mehnajjimy/ColdPlateTwin/docs/figures/coldplate_closeup.png

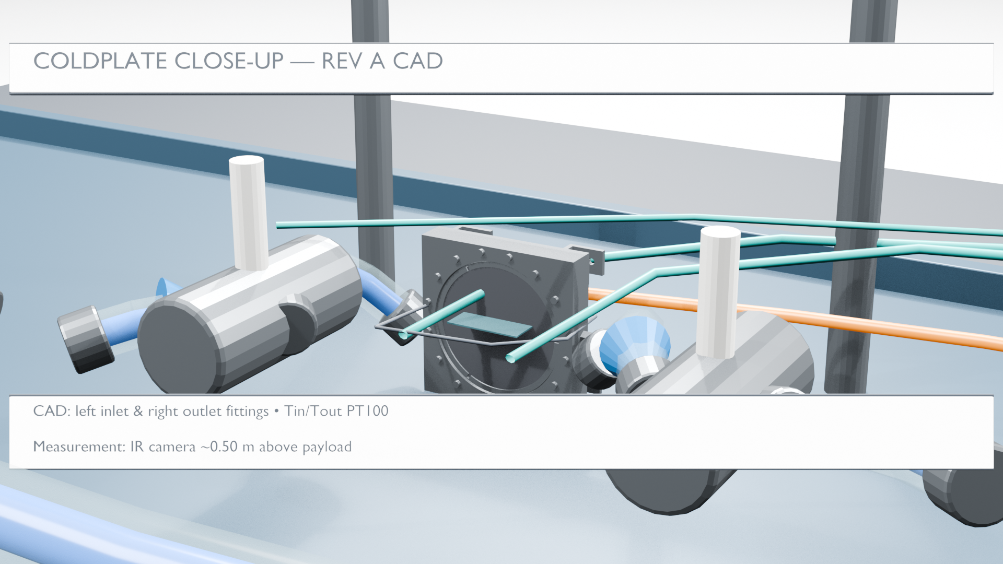
docs/figures/coldplate_closeup.png
