mehnajjimy/ColdPlateTwin/exports/step/FI-200_fluid_domain.step

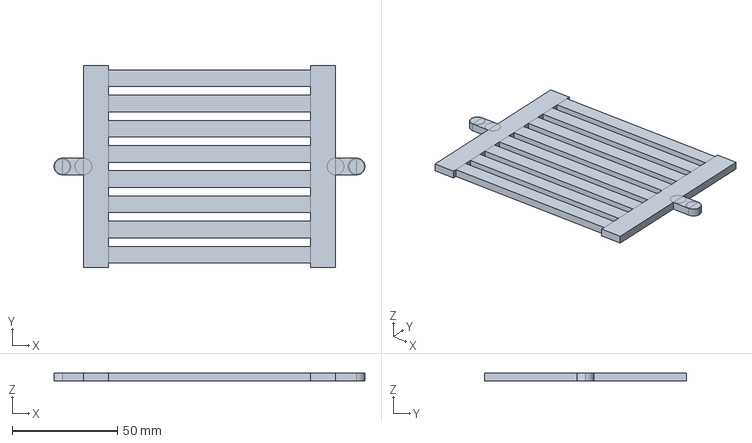
[picture p5: CAD file, 2026-09-17]
exports/step/FI-200_fluid_domain.step
148.0 x 96.0 x 4.00 mm
