mehnajjimy/ColdPlateTwin/visualization/blender_mesh/coldplate_assembly_meters.obj

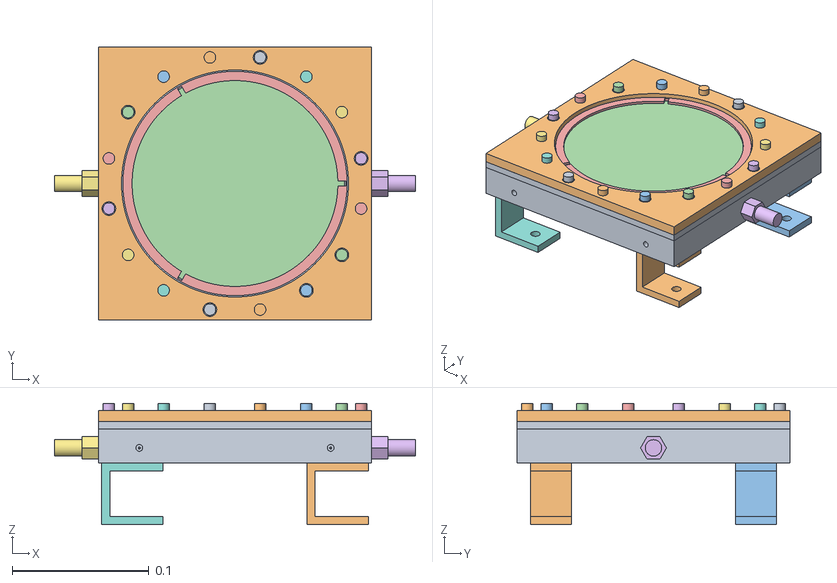
[picture p6: CAD file, 2026-09-17]
visualization/blender_mesh/coldplate_assembly_meters.obj
0.264 x 0.2 x 0.0885
CP-001_BASE_000
FI-100_000
FI-100_RIB_GASKET_000
FI-100_RIB_GASKET001_000
FI-100_RIB_GASKET002_000
GS-001_MAIN_ORING_000
GS-013_TRANSFER_ORINGS_2X_000
GS-013_TRANSFER_ORINGS_2X001_000
CP-002_COVER_000
CL-002_STRUCTURAL_CLAMP_000
HEATER_PROVISIONAL_ENVELOPE_000
TH-001_PAYLOAD_000
CL-001_PAYLOAD_CLAMP_000
M5X25_SCREWS_16X_000
M5X25_SCREWS_16X001_000
M5X25_SCREWS_16X002_000
M5X25_SCREWS_16X003_000
M5X25_SCREWS_16X004_000
M5X25_SCREWS_16X005_000
M5X25_SCREWS_16X006_000
M5X25_SCREWS_16X007_000
M5X25_SCREWS_16X008_000
M5X25_SCREWS_16X009_000
M5X25_SCREWS_16X010_000
M5X25_SCREWS_16X011_000
M5X25_SCREWS_16X012_000
M5X25_SCREWS_16X013_000
M5X25_SCREWS_16X014_000
M5X25_SCREWS_16X015_000
M5_WASHERS_16X_000
M5_WASHERS_16X001_000
M5_WASHERS_16X002_000
M5_WASHERS_16X003_000
M5_WASHERS_16X004_000
M5_WASHERS_16X005_000
M5_WASHERS_16X006_000
M5_WASHERS_16X007_000
M5_WASHERS_16X008_000
M5_WASHERS_16X009_000
M5_WASHERS_16X010_000
M5_WASHERS_16X011_000
M5_WASHERS_16X012_000
M5_WASHERS_16X013_000
M5_WASHERS_16X014_000
M5_WASHERS_16X015_000
NPT_RIGHT_ENVELOPE_000
NPT_LEFT_ENVELOPE_000
BR-001_0_0_000
BR-001_0_1_000
BR-001_1_0_000
BR-001_1_1_000
