mehnajjimy/ColdPlateTwin/exports/step/CP-REV-A_assembly_FI-100.step

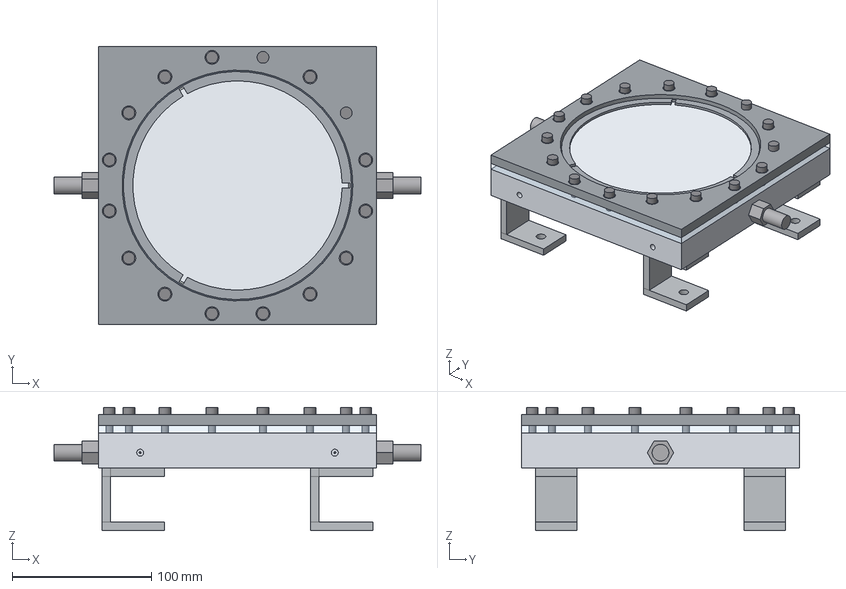
[picture p8: CAD file, 2026-09-17]
exports/step/CP-REV-A_assembly_FI-100.step
264.0 x 200.0 x 88.5 mm
CP-001_BASE
FI-100
FI-100_RIB_GASKET
GS-001_MAIN_ORING
GS-013_TRANSFER_ORINGS_2X
CP-002_COVER
CL-002_STRUCTURAL_CLAMP
HEATER_PROVISIONAL_ENVELOPE
TH-001_PAYLOAD
CL-001_PAYLOAD_CLAMP
M5X25_SCREWS_16X
M5_WASHERS_16X
NPT_RIGHT_ENVELOPE
NPT_LEFT_ENVELOPE
BR-001_0_0
BR-001_0_1
BR-001_1_0
BR-001_1_1
