mehnajjimy/ColdPlateTwin/exports/step/FI-000_fluid_domain.step

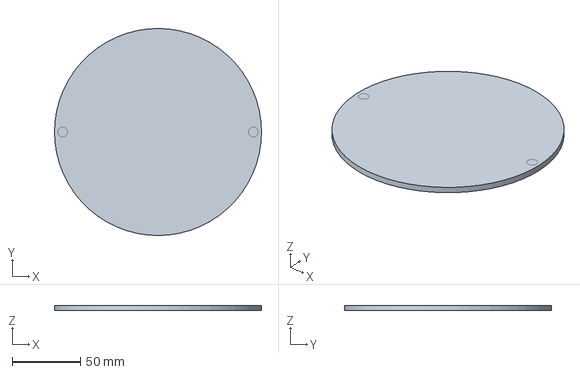
[picture p9: CAD file, 2026-09-17]
exports/step/FI-000_fluid_domain.step
152.0 x 152.0 x 4.00 mm
