mehnajjimy/ColdPlateTwin/exports/step/FI-100_fluid_domain.step

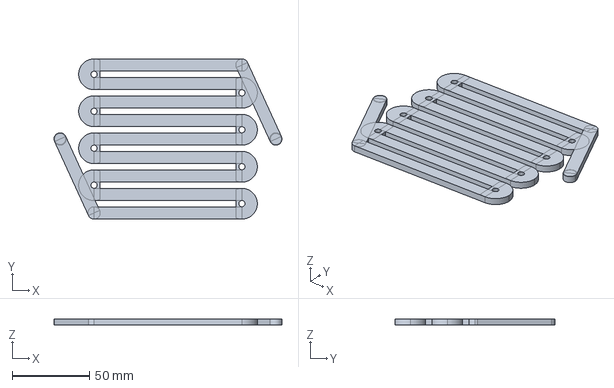
[picture p10: CAD file, 2026-09-17]
exports/step/FI-100_fluid_domain.step
148.0 x 104.0 x 4.00 mm
