mehnajjimy/ColdPlateTwin/exports/dxf/FI-100_gasket_cutting_outline.dxf

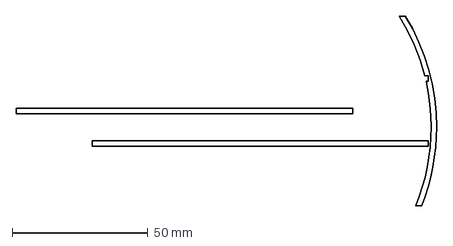
[picture p11: CAD file, 2026-09-17]
exports/dxf/FI-100_gasket_cutting_outline.dxf
155.0 x 70.0 mm
