mehnajjimy/ColdPlateTwin/exports/stl/FI-200_prototype.stl

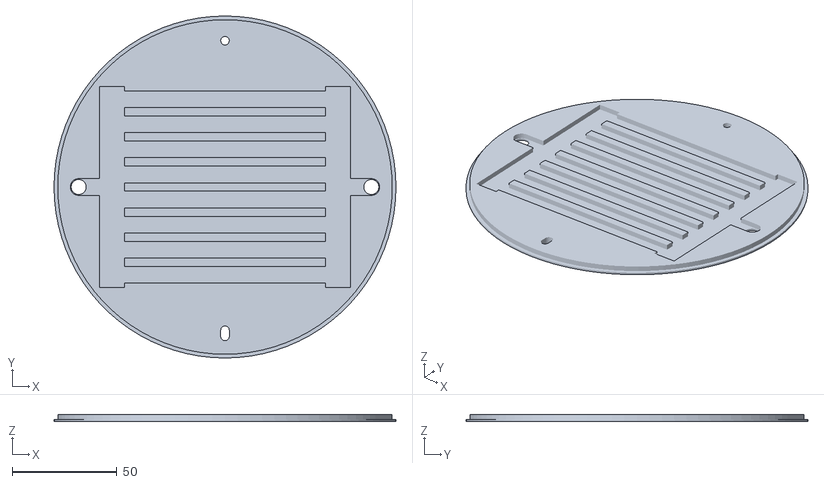
[picture p12: CAD file, 2026-09-17]
exports/stl/FI-200_prototype.stl
163.6 x 163.6 x 3.50
