mehnajjimy/ColdPlateTwin/exports/dxf/FI-000_gasket_cutting_outline.dxf

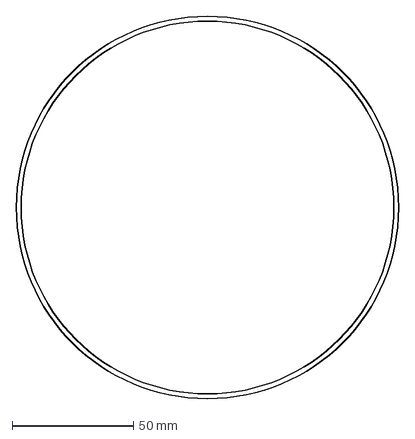
[picture p13: CAD file, 2026-09-17]
exports/dxf/FI-000_gasket_cutting_outline.dxf
158.0 x 158.0 mm
