mehnajjimy/ColdPlateTwin/exports/step/BR-001_bench_bracket.step

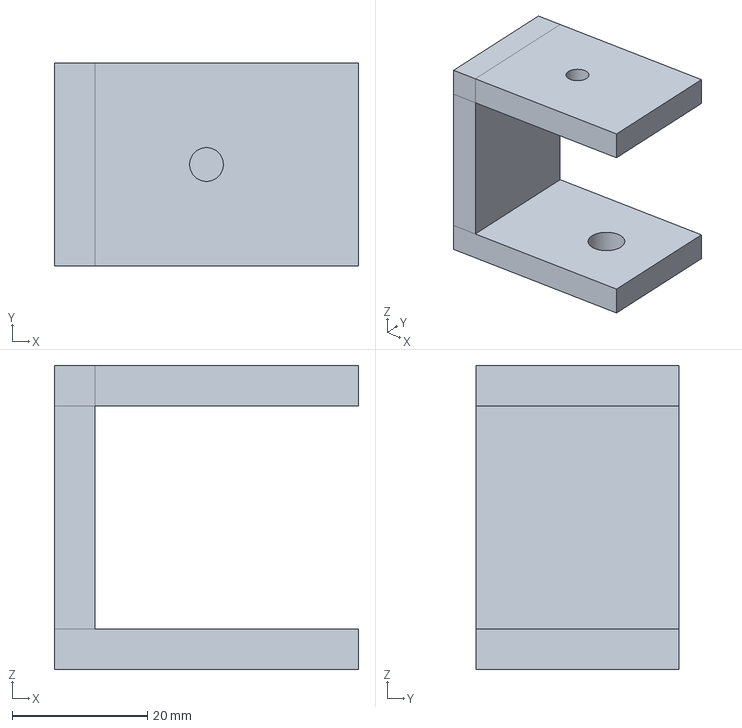
[picture p14: CAD file, 2026-09-17]
exports/step/BR-001_bench_bracket.step
45.0 x 30.0 x 45.0 mm
