mehnajjimy/ColdPlateTwin/exports/stl/FI-100_prototype.stl

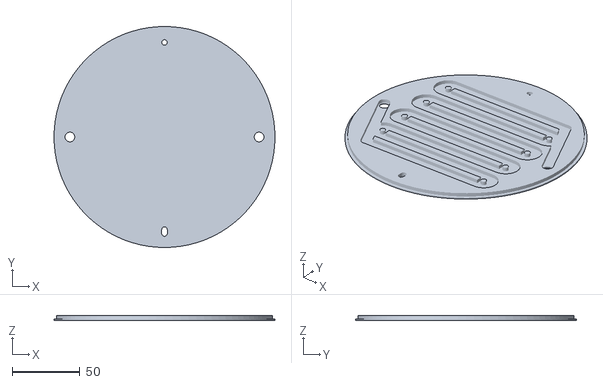
[picture p15: CAD file, 2026-09-17]
exports/stl/FI-100_prototype.stl
163.6 x 163.6 x 3.50
