mehnajjimy/ColdPlateTwin/exports/step/FI-000_insert.step

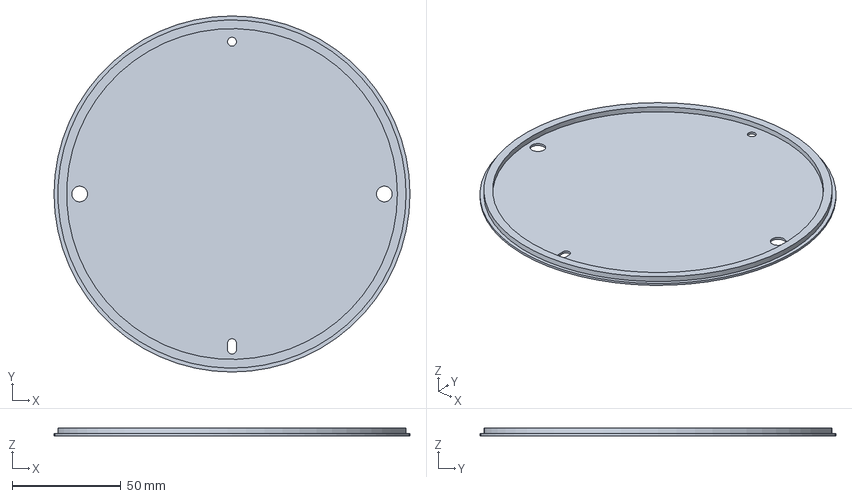
[picture p17: CAD file, 2026-09-17]
exports/step/FI-000_insert.step
163.6 x 163.6 x 3.50 mm
