mehnajjimy/ColdPlateTwin/exports/dxf/FI-200_gasket_cutting_outline.dxf

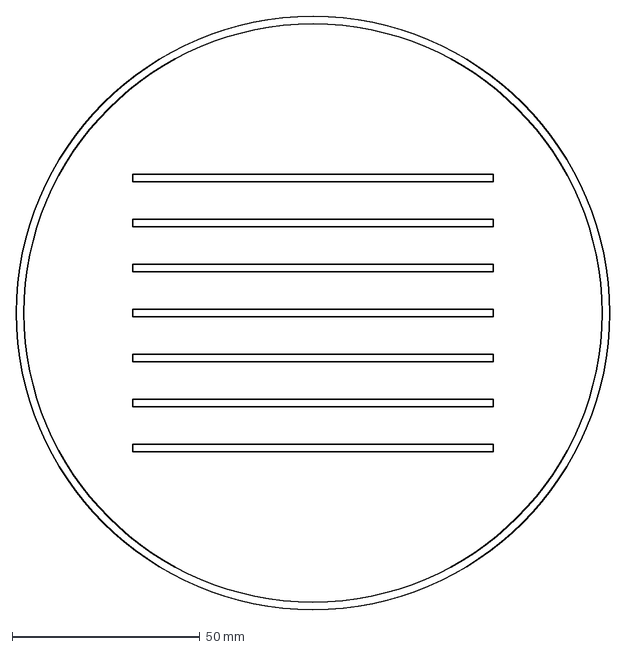
[picture p18: CAD file, 2026-09-17]
exports/dxf/FI-200_gasket_cutting_outline.dxf
158.0 x 158.0 mm
