mehnajjimy/ColdPlateTwin/exports/step/FI-100_rib_gasket.step

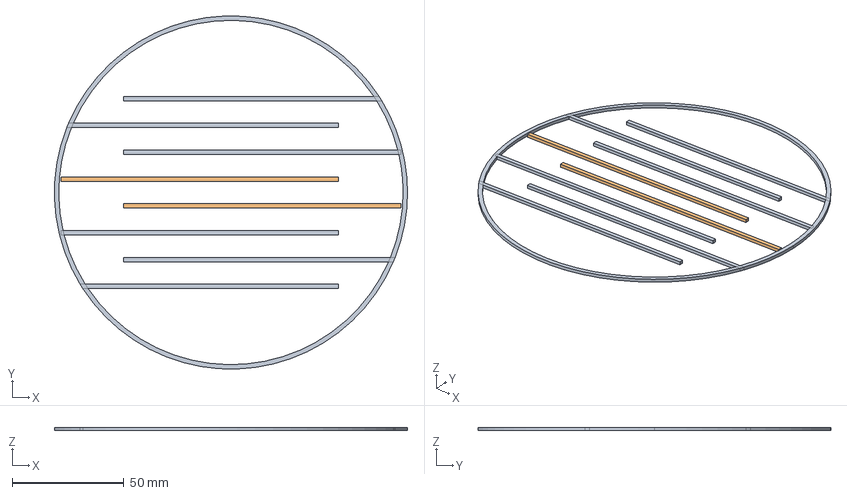
[picture p19: CAD file, 2026-09-17]
exports/step/FI-100_rib_gasket.step
158.0 x 157.9 x 1.50 mm
