mehnajjimy/ColdPlateTwin/exports/step/CL-002_structural_clamp.step

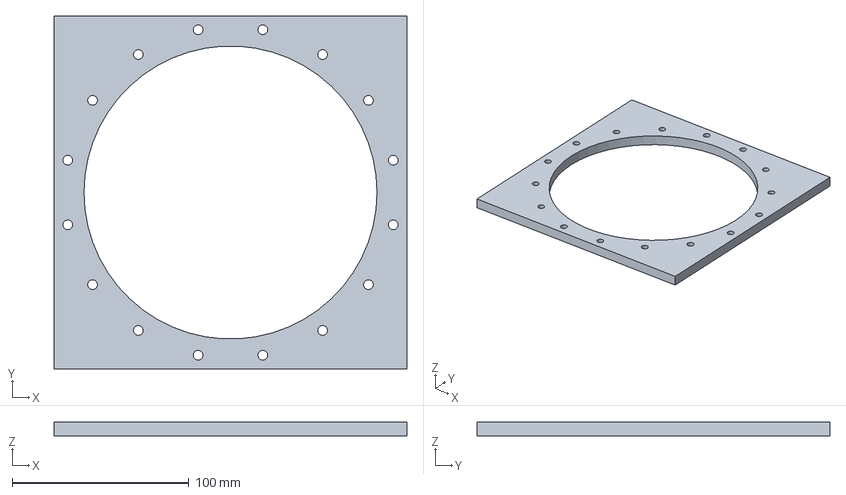
[picture p20: CAD file, 2026-09-17]
exports/step/CL-002_structural_clamp.step
200.0 x 200.0 x 8.00 mm
