mehnajjimy/ColdPlateTwin/exports/step/HW-NPT-1_4_candidate_envelope.step

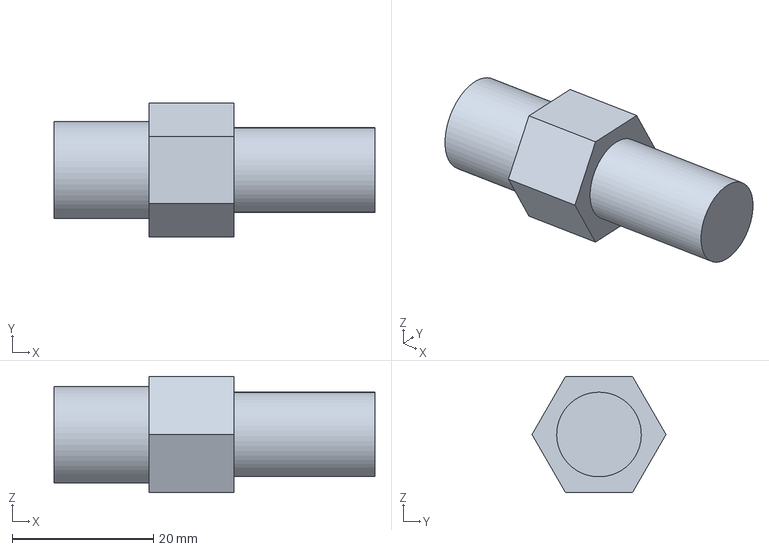
[picture p21: CAD file, 2026-09-17]
exports/step/HW-NPT-1_4_candidate_envelope.step
45.5 x 19.0 x 16.5 mm
