mehnajjimy/ColdPlateTwin/exports/step/CL-001_payload_clamp.step

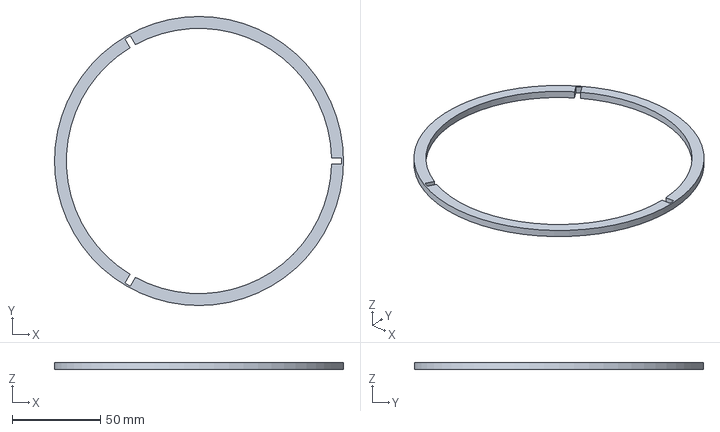
[picture p22: CAD file, 2026-09-17]
exports/step/CL-001_payload_clamp.step
164.0 x 164.0 x 4.00 mm
