mehnajjimy/ColdPlateTwin/exports/step/CP-001_base.step

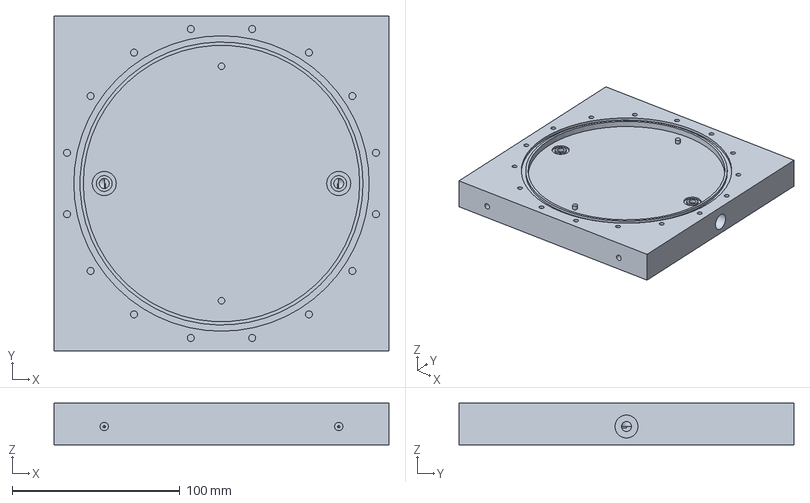
[picture p24: CAD file, 2026-09-17]
exports/step/CP-001_base.step
200.0 x 200.0 x 25.0 mm
