mehnajjimy/ColdPlateTwin/exports/step/GS-001_AS568-166_envelope.step

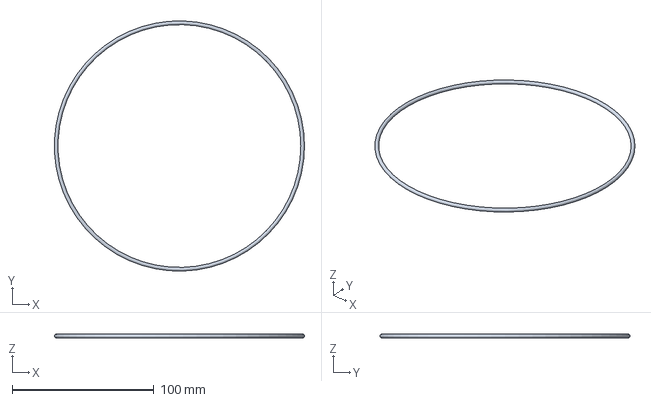
[picture p25: CAD file, 2026-09-17]
exports/step/GS-001_AS568-166_envelope.step
176.2 x 176.3 x 2.62 mm
