mehnajjimy/ColdPlateTwin/exports/step/TH-001_payload.step

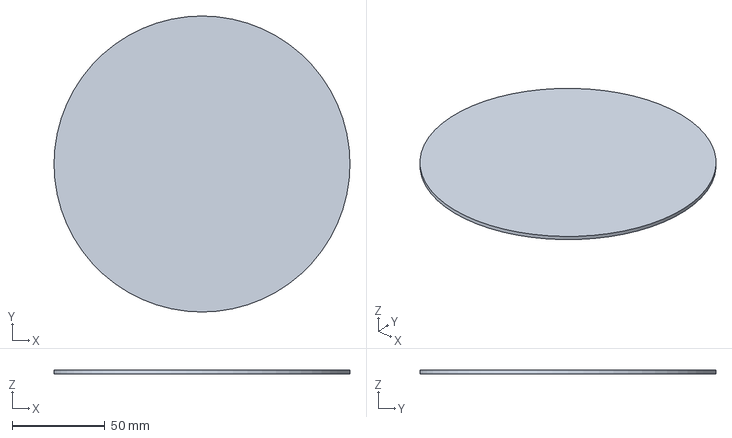
[picture p26: CAD file, 2026-09-17]
exports/step/TH-001_payload.step
160.0 x 160.0 x 2.00 mm
