mehnajjimy/ColdPlateTwin/exports/step/HT-001_heater_provisional_envelope.step

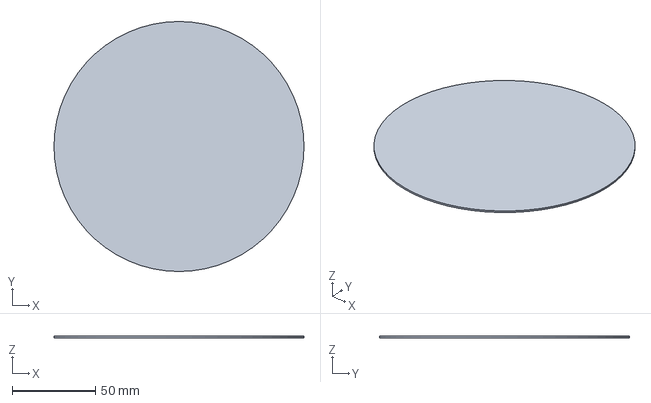
[picture p27: CAD file, 2026-09-17]
exports/step/HT-001_heater_provisional_envelope.step
150.0 x 150.0 x 1.00 mm
