mehnajjimy/ColdPlateTwin/exports/step/GS-013_transfer_orings_2x.step

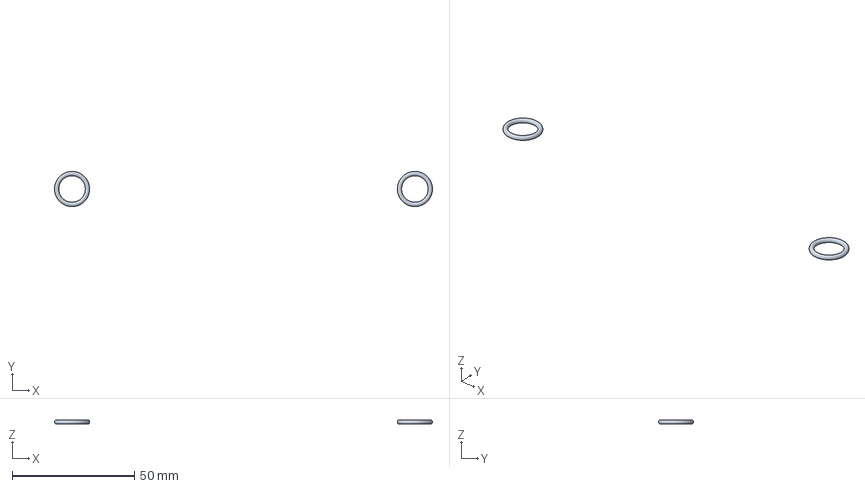
[picture p28: CAD file, 2026-09-17]
exports/step/GS-013_transfer_orings_2x.step
154.4 x 14.4 x 1.78 mm
