mehnajjimy/ColdPlateTwin/exports/step/CP-002_cover.step

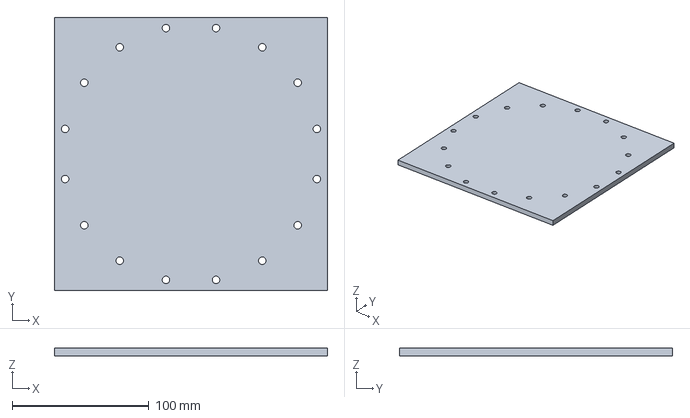
[picture p29: CAD file, 2026-09-17]
exports/step/CP-002_cover.step
200.0 x 200.0 x 5.50 mm
