mehnajjimy/ColdPlateTwin/exports/step/FI-000_rib_gasket.step

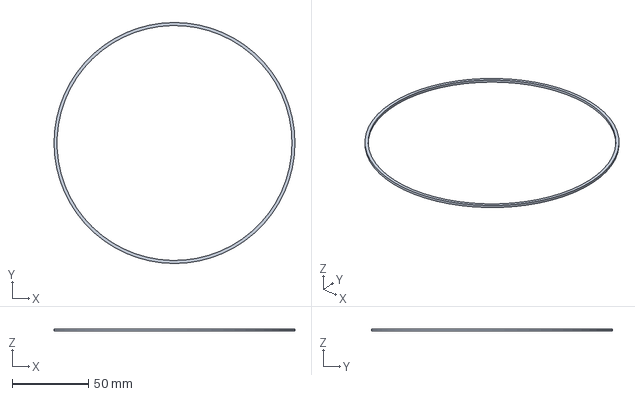
[picture p30: CAD file, 2026-09-17]
exports/step/FI-000_rib_gasket.step
158.0 x 158.0 x 1.50 mm
