mehnajjimy/ColdPlateTwin/exports/step/CP-REV-A_insert_family.step

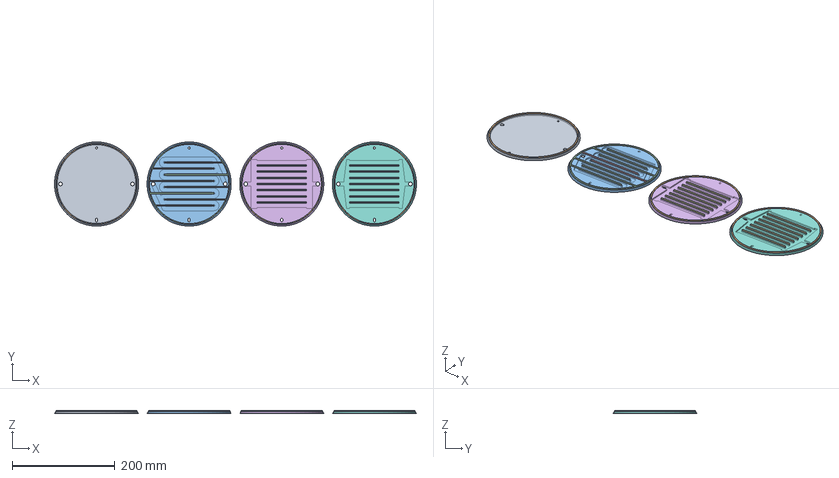
[picture p32: CAD file, 2026-09-17]
exports/step/CP-REV-A_insert_family.step
703.4 x 163.5 x 5.00 mm
FI-000
FI-000_GASKET
FI-100
FI-100_GASKET
FI-200
FI-200_GASKET
FI-300
FI-300_GASKET
