mehnajjimy/ColdPlateTwin/(list of files, cad)

Other CAD files:
freecad/ColdPlate_RevA.FCStd
exports/stl/FI-000_prototype.stl
exports/stl/FI-300_prototype.stl
exports/step/FI-100_insert.step
exports/step/FI-200_rib_gasket.step
exports/step/FI-200_insert.step
exports/step/FI-300_insert.step
exports/step/HW-M5_washer_envelope.step
exports/step/HW-M5x25_screw_envelope.step
visualization/ColdPlateTwin_experiment.blend
